BETA-KNH/beta-hardware/beta-main/docs/beta-main.pdf

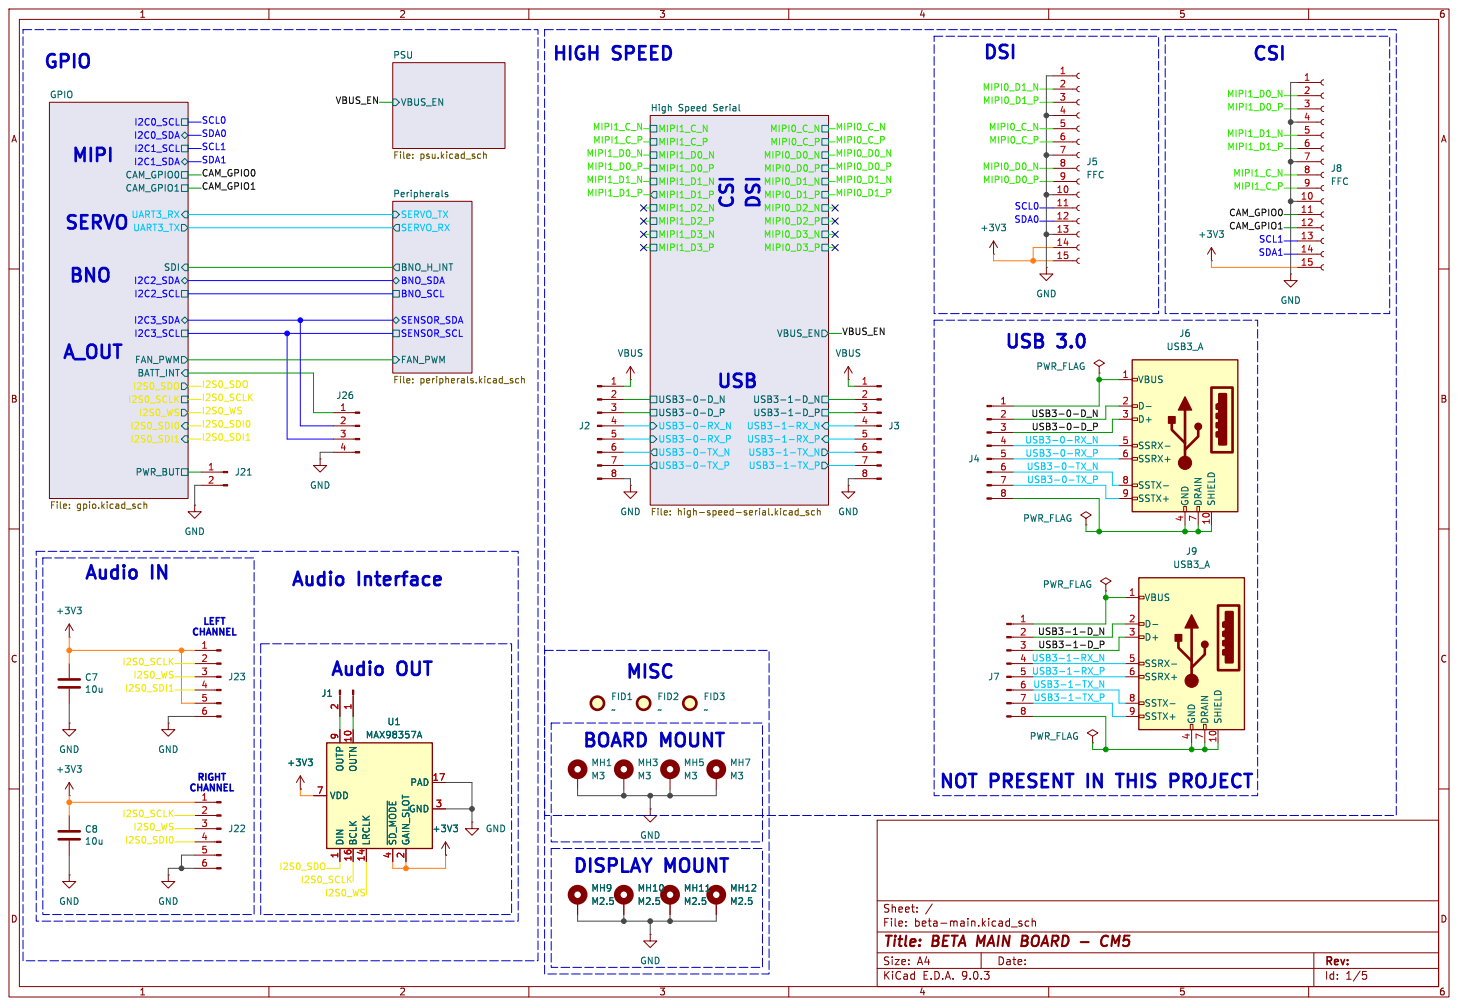
[picture p1: page 1]

DSI
USB3-0-TX_P MIPI1_D3_P MIPI1_D1_P High Speed Serial File: high-speed-serial.kicad_sch

4 VBUS 1 D- 2 D+ 3 SSRX- 5 SSRX+ 6 SSTX- 8 SSTX+ 9

LEFT CHANNEL Audio IN
+3V3 GND

2 GND 3 VDD 7 PAD 17 OUTP

File: beta-main.kicad_sch Sheet: /
Id: 1/5 Title: BETA MAIN BOARD - CM5

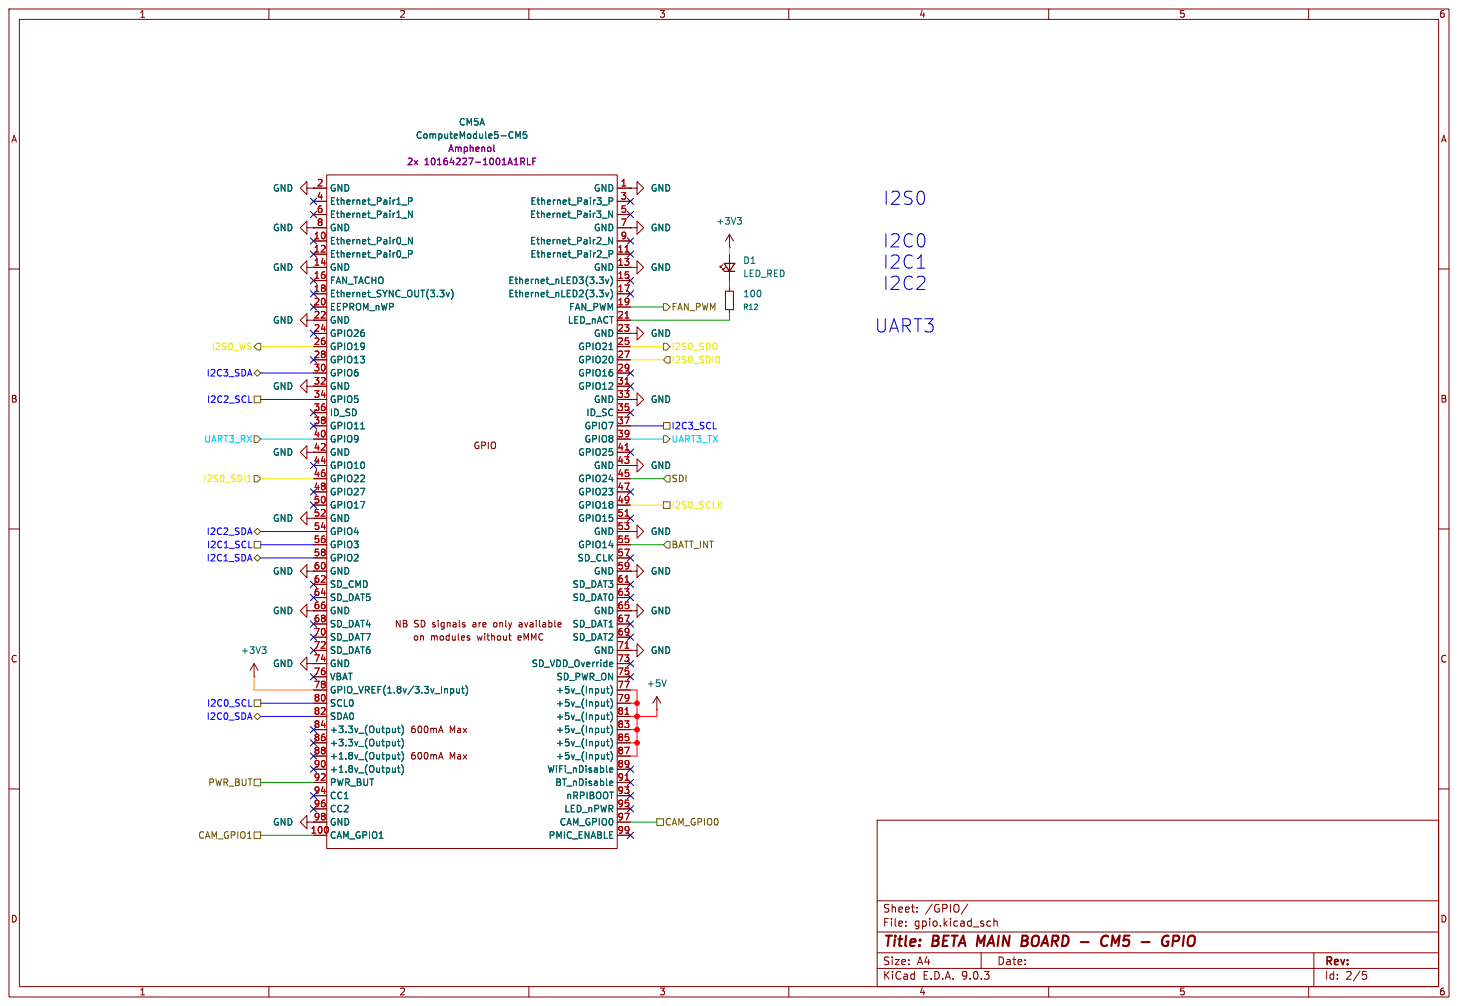
[picture p2: page 2]

GND GND

on modules without eMMC GPIO

600mA Max 600mA Max NB SD signals are only available

File: gpio.kicad_sch Sheet: /GPIO/ GND

Id: 2/5 Title: BETA MAIN BOARD - CM5 - GPIO

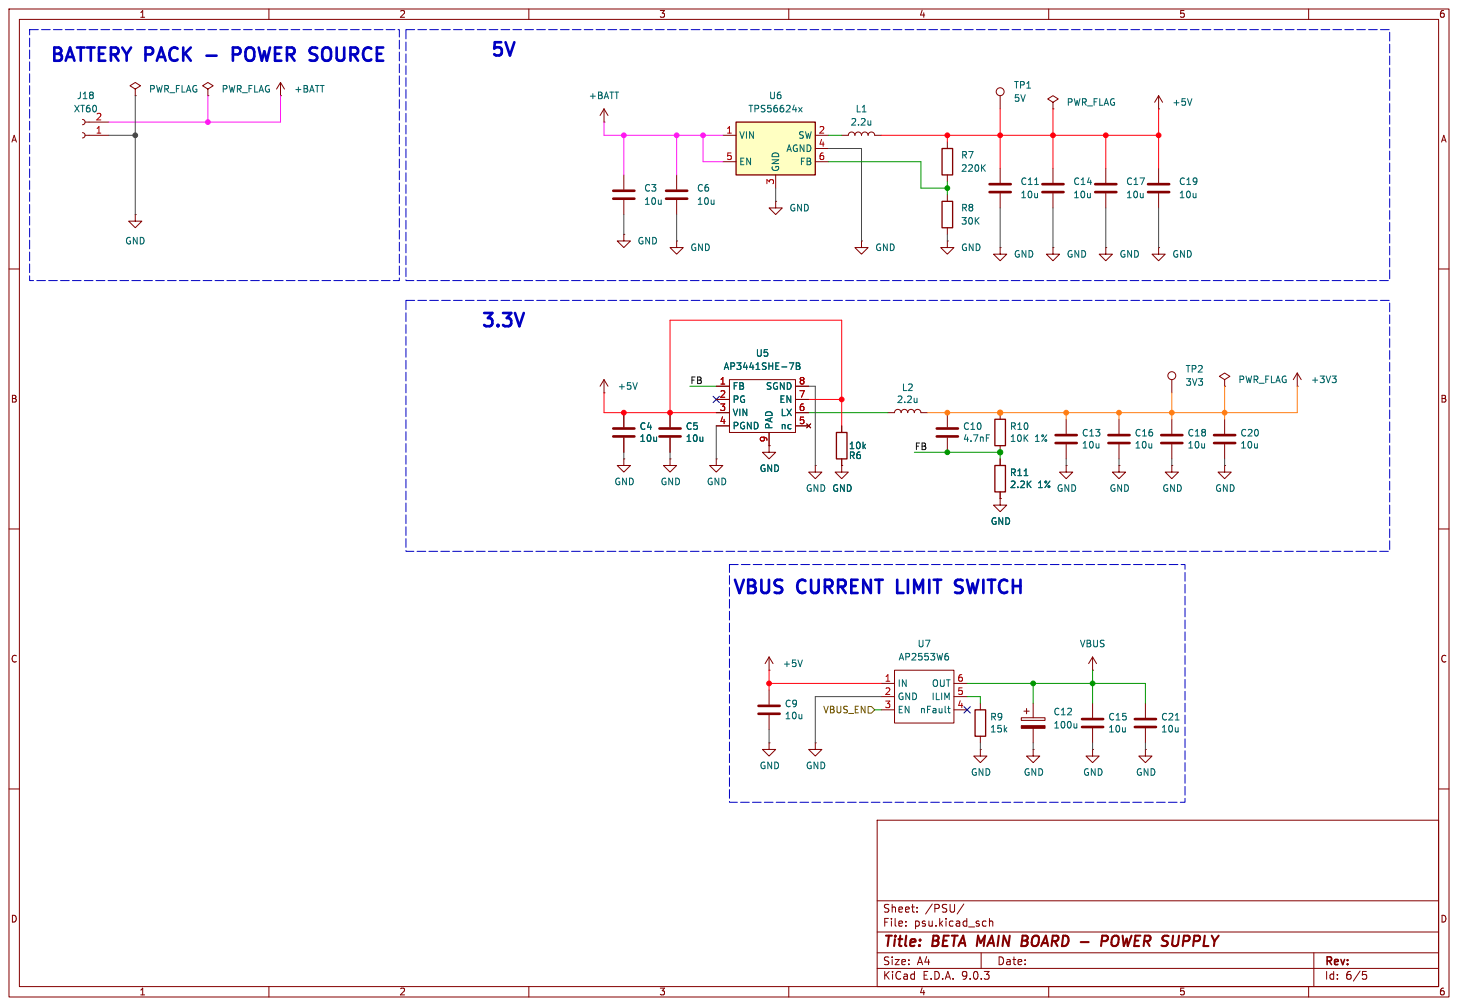
[picture p3: page 3]

3 SW 2 AGND 4 FB 6 U6 TPS56624x GND

File: psu.kicad_sch Sheet: /PSU/
Id: 6/5 Title: BETA MAIN BOARD - POWER SUPPLY

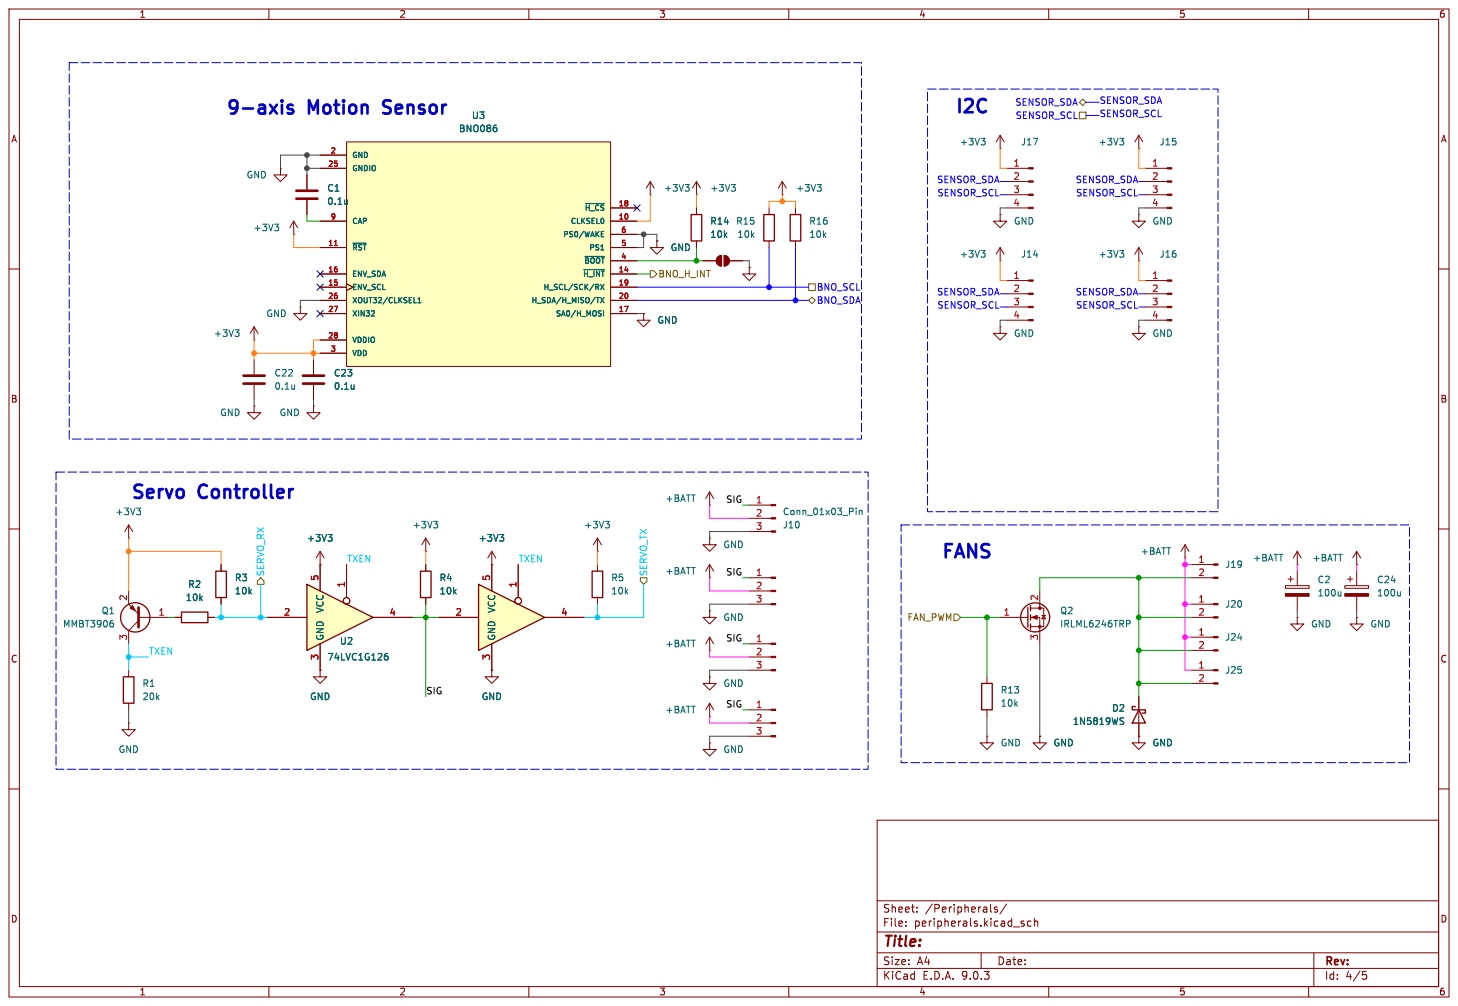
[picture p4: page 4]

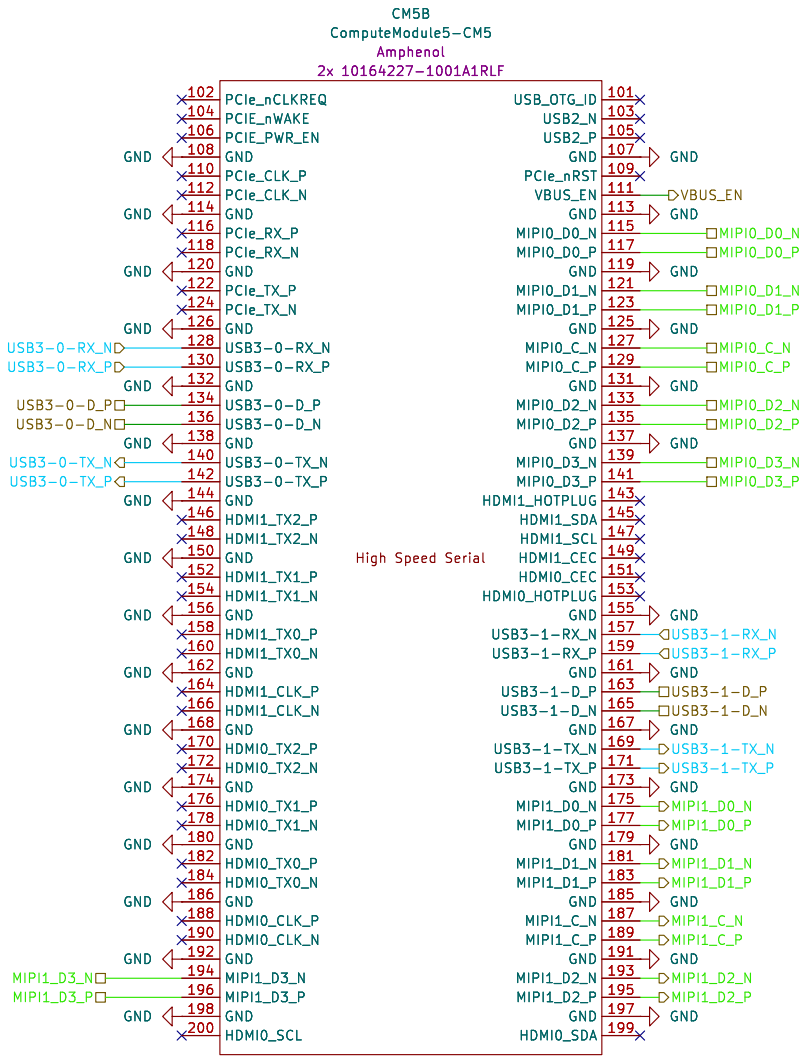
[picture p5: page 5]

GND GND GND GND GND GND GND GND GND

Id: 3/5 Title: BETA MAIN BOARD - CM5 - High Speed Interface
