BETA-KNH/beta-hardware/beta-main/beta-main.kicad_pcb

## KiCad design beta-main/beta-main.kicad_pcb (2026-03-09)

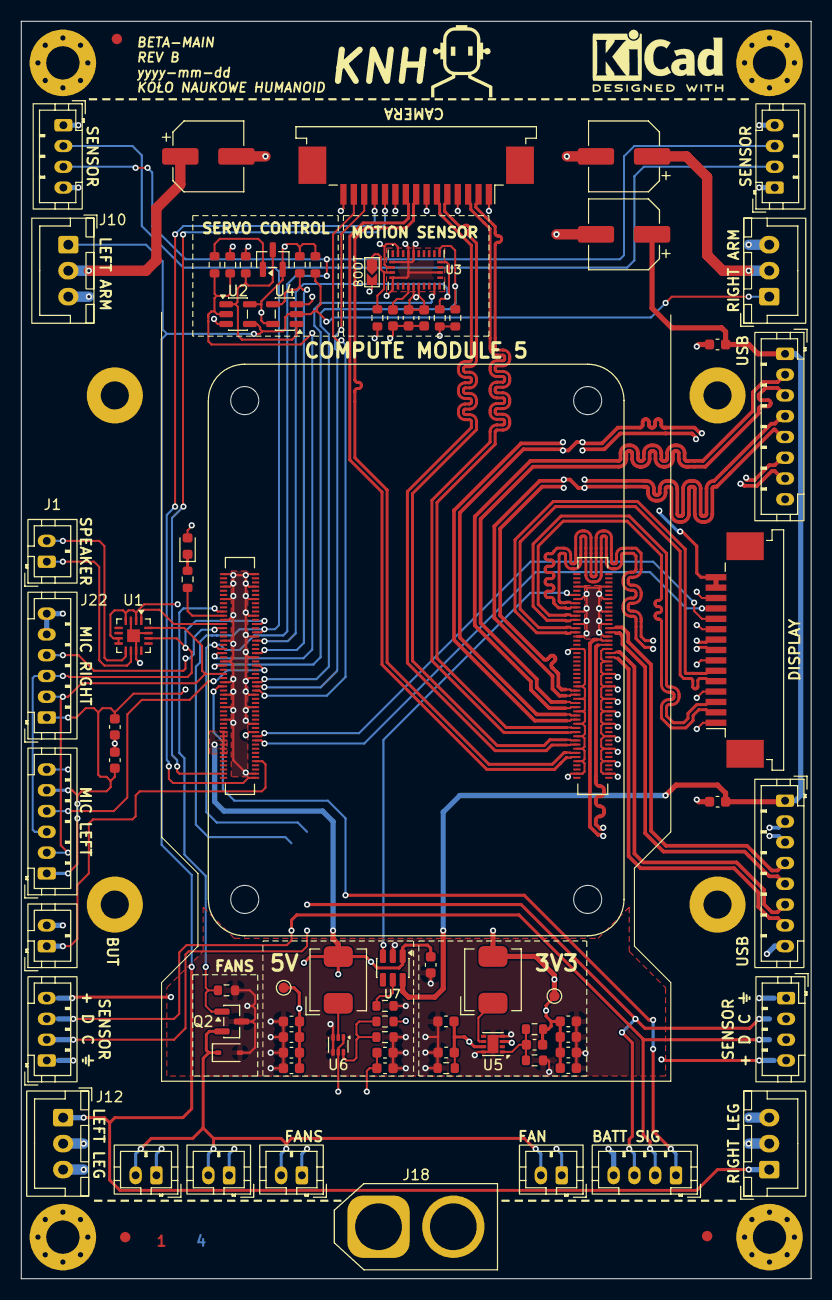
[picture p6: board beta-main.kicad_pcb from above]

Board: 4 copper layers, 76.0 x 121.0 mm, 90 parts (0 on the bottom side), 66 nets.

Parts:
C1, C22, C23: 0.1u; C_0603_1608Metric
C2, C12, C24: 100u; CP_Elec_6.3x5.7
C3, C4, C5, C6, C7, C8, C9, C11, C13, C14, C15, C16, C17, C18, C19, C20, C21: 10u; C_0603_1608Metric
C10: 4.7nF; C_0603_1608Metric
CM5: ComputeModule5-CM5; Raspberry-Pi-5-Compute-Module
D1: LED_RED; LED_0603_1608Metric
D2: 1N5819WS; D_SOD-323
FID1, FID2, FID3: Fiducial_1mm_Mask2mm
J1, J19, J20, J21, J24, J25: Conn_01x02_Pin; JST_PH_B2B-PH-K_1x02_P2.00mm_Vertical
J2, J3: Conn_01x08_Pin; JST_PH_B8B-PH-K_1x08_P2.00mm_Vertical
J5, J8: FFC; TE_1-84953-5_1x15-1MP_P1.0mm_Horizontal
J10, J11, J12, J13: Conn_01x03_Pin; JST_XH_B3B-XH-A_1x03_P2.50mm_Vertical
J14, J15, J16, J17, J26: Conn_01x04_Pin; JST_PH_B4B-PH-K_1x04_P2.00mm_Vertical
J18: XT60; AMASS_XT60-F_1x02_P7.20mm_Vertical
J22, J23: Conn_01x06_Pin; JST_PH_B6B-PH-K_1x06_P2.00mm_Vertical
JP1: SolderJumper_2_Open; SolderJumper-2
L1, L2: 2.2u; L_Bourns_SRP5030CC
MH1, MH3, MH5, MH7: M3; MountingHole_3.2mm_M3_Pad_Via
MH9, MH10, MH11, MH12: M2.5; MountingHole_2.7mm_Pad
Q1: MMBT3906; SOT-23
Q2: IRLML6246TRP; SOT-23
R1: 20k; R_0603_1608Metric
R2, R3, R4, R5, R6, R13, R14, R15, R16: 10k; R_0603_1608Metric
R7: 220K; R_0603_1608Metric
R8: 30K; R_0603_1608Metric
R9: 15k; R_0603_1608Metric
R10: 10K 1%; R_0603_1608Metric
R11: 2.2K 1%; R_0603_1608Metric
R12: 100; R_0603_1608Metric
TP1: 5V; TestPoint_Pad_D1.0mm
TP2: 3V3; TestPoint_Pad_D1.0mm
U1: MAX98357A; TQFN-16-1EP_3x3mm_P0.5mm_EP1.23x1.23mm
U2, U4: 74LVC1G126; SOT-23-5
U3: BNO086; IC_BNO086
U5: AP3441SHE-7B; DFN-8-1EP_2x2mm_P0.5mm_EP1.05x1.75mm
U6: TPS56624x; SOT-563
U7: AP2553W6; SOT-23-6

Connections:
+3V3: C7.1, C8.1, C10.1, C13.1, C16.1, C18.1, C20.1, C22.1, C23.1, CM5.78 (GPIO_VREF(1.8v/3.3v_Input)), D1.2 (A), J5.14, J5.15, J8.15, J14.1, J15.1, J16.1, J17.1, J22.1, J23.1, J23.5, L2.2, Q1.2 (E), R3.1, R4.1, R5.1, R10.1, R14.1, R15.1, R16.1, TP2.1, U1.2 (GAIN_SLOT), U1.4 (~SD_MODE), U1.7 (VDD), U1.8 (VDD), U2.5 (VCC), U3.3 (VDD), U3.10 (CLKSEL0), U3.11 (~RST), U3.28 (VDDIO), U4.5 (VCC)
+5V: C4.1, C5.1, C9.1, C11.1, C14.1, C17.1, C19.1, CM5.77 (+5v_(Input)), CM5.79 (+5v_(Input)), CM5.81 (+5v_(Input)), CM5.83 (+5v_(Input)), CM5.85 (+5v_(Input)), CM5.87 (+5v_(Input)), L1.2, R6.1, R7.1, TP1.1, U5.3 (VIN), U5.7 (EN), U7.1 (IN)
+BATT: C2.1, C3.1, C6.1, C24.1, J10.2, J11.2, J12.2, J13.2, J18.2, J19.1, J20.1, J24.1, J25.1, U6.1 (VIN), U6.5 (EN)
/CAM_GPIO0: CM5.97 (CAM_GPIO0), J8.11
/CAM_GPIO1: CM5.100 (CAM_GPIO1), J8.12
/GPIO/BATT_INT: CM5.55 (GPIO14), J26.1
/GPIO/FAN_PWM: CM5.19 (FAN_PWM), Q2.1 (G), R13.1
/GPIO/I2C2_SCL: CM5.34 (GPIO5), R15.2, U3.19 (H_SCL/SCK/RX)
/GPIO/I2C2_SDA: CM5.54 (GPIO4), R16.2, U3.20 (H_SDA/H_MISO/TX)
/GPIO/PWR_BUT: CM5.92 (PWR_BUT), J21.1
/GPIO/SDI: CM5.45 (GPIO24), U3.14 (~H_INT)
/GPIO/UART3_RX: CM5.40 (GPIO9), R5.2, U4.4
/GPIO/UART3_TX: CM5.39 (GPIO8), R2.2, R3.2, U2.2
/High Speed Serial/USB3-0-D_N: CM5.136 (USB3-0-D_N), J2.2
/High Speed Serial/USB3-0-D_P: CM5.134 (USB3-0-D_P), J2.3
/High Speed Serial/USB3-0-RX_N: CM5.128 (USB3-0-RX_N), J2.4
/High Speed Serial/USB3-0-RX_P: CM5.130 (USB3-0-RX_P), J2.5
/High Speed Serial/USB3-0-TX_N: CM5.140 (USB3-0-TX_N), J2.6
/High Speed Serial/USB3-0-TX_P: CM5.142 (USB3-0-TX_P), J2.7
/High Speed Serial/USB3-1-D_N: CM5.165 (USB3-1-D_N), J3.2
/High Speed Serial/USB3-1-D_P: CM5.163 (USB3-1-D_P), J3.3
/High Speed Serial/USB3-1-RX_N: CM5.157 (USB3-1-RX_N), J3.4
/High Speed Serial/USB3-1-RX_P: CM5.159 (USB3-1-RX_P), J3.5
/High Speed Serial/USB3-1-TX_N: CM5.169 (USB3-1-TX_N), J3.6
/High Speed Serial/USB3-1-TX_P: CM5.171 (USB3-1-TX_P), J3.7
/I2S0_SCLK: CM5.49 (GPIO18), J22.2, J23.2, U1.16 (BCLK)
/I2S0_SDI0: CM5.27 (GPIO20), J22.4
/I2S0_SDI1: CM5.46 (GPIO22), J23.4
/I2S0_SDO: CM5.25 (GPIO21), U1.1 (DIN)
/I2S0_WS: CM5.26 (GPIO19), J22.3, J23.3, U1.14 (LRCLK)
/MIPI0_C_N: CM5.127 (MIPI0_C_N), J5.5
/MIPI0_C_P: CM5.129 (MIPI0_C_P), J5.6
/MIPI0_D0_N: CM5.115 (MIPI0_D0_N), J5.8
/MIPI0_D0_P: CM5.117 (MIPI0_D0_P), J5.9
/MIPI0_D1_N: CM5.121 (MIPI0_D1_N), J5.2
/MIPI0_D1_P: CM5.123 (MIPI0_D1_P), J5.3
/MIPI1_C_N: CM5.187 (MIPI1_C_N), J8.8
/MIPI1_C_P: CM5.189 (MIPI1_C_P), J8.9
/MIPI1_D0_N: CM5.175 (MIPI1_D0_N), J8.2
/MIPI1_D0_P: CM5.177 (MIPI1_D0_P), J8.3
/MIPI1_D1_N: CM5.181 (MIPI1_D1_N), J8.5
/MIPI1_D1_P: CM5.183 (MIPI1_D1_P), J8.6
/PSU/FB: C10.2, R10.2, R11.1, U5.1 (FB)
/Peripherals/SENSOR_SCL: CM5.37 (GPIO7), J14.3, J15.3, J16.3, J17.3, J26.3
/Peripherals/SENSOR_SDA: CM5.30 (GPIO6), J14.2, J15.2, J16.2, J17.2, J26.2
/Peripherals/SIG: J10.1, J11.1, J12.1, J13.1, R4.2, U2.4, U4.2
/Peripherals/TXEN: Q1.3 (C), R1.2, U2.1, U4.1
/SCL0: CM5.80 (SCL0), J5.11
/SCL1: CM5.56 (GPIO3), J8.13
/SDA0: CM5.82 (SDA0), J5.12
/SDA1: CM5.58 (GPIO2), J8.14
/VBUS_EN: CM5.111 (VBUS_EN), U7.3 (EN)
GND: C1.1, C2.2, C3.2, C4.2, C5.2, C6.2, C7.2, C8.2, C9.2, C11.2, C12.2, C13.2, C14.2, C15.2, C16.2, C17.2, C18.2, C19.2, C20.2, C21.2, C22.2, C23.2, C24.2, CM5.1 (GND), CM5.2 (GND), CM5.7 (GND), CM5.8 (GND), CM5.13 (GND), CM5.14 (GND), CM5.22 (GND), CM5.23 (GND), CM5.32 (GND), CM5.33 (GND), CM5.42 (GND), CM5.43 (GND), CM5.52 (GND), CM5.53 (GND), CM5.59 (GND), CM5.60 (GND), CM5.65 (GND), CM5.66 (GND), CM5.71 (GND), CM5.74 (GND), CM5.98 (GND), CM5.107 (GND), CM5.108 (GND), CM5.113 (GND), CM5.114 (GND), CM5.119 (GND), CM5.120 (GND), CM5.125 (GND), CM5.126 (GND), CM5.131 (GND), CM5.132 (GND), CM5.137 (GND), CM5.138 (GND), CM5.144 (GND), CM5.150 (GND), CM5.155 (GND), CM5.156 (GND), CM5.161 (GND), CM5.162 (GND), CM5.167 (GND), CM5.168 (GND), CM5.173 (GND), CM5.174 (GND), CM5.179 (GND), CM5.180 (GND), CM5.185 (GND), CM5.186 (GND), CM5.191 (GND), CM5.192 (GND), CM5.197 (GND), CM5.198 (GND), D2.2 (A), J2.8, J3.8, J5.1, J5.4, J5.7, J5.10, J5.13, J8.1, J8.4, J8.7, J8.10, J10.3, J11.3, J12.3, J13.3, J14.4, J15.4, J16.4, J17.4, J18.1, J21.2, J22.5, J22.6, J23.6, J26.4, JP1.2 (B), MH1.1, MH3.1, MH5.1, MH7.1, MH9.1, MH10.1, MH11.1, MH12.1, Q2.3 (S), R1.1, R6.2, R8.2, R9.2, R11.2, R13.2, U1.3 (GND), U1.11 (GND), U1.15 (GND), U1.17 (PAD), U2.3 (GND), U3.2 (GND), U3.5 (PS1), U3.6 (PS0/WAKE), U3.17 (SA0/H_MOSI), U3.25 (GNDIO), U3.26 (XOUT32/CLKSEL1), U4.3 (GND), U5.4 (PGND), U5.8 (SGND), U5.9 (PAD), U6.3 (GND), U6.4 (AGND), U7.2 (GND)
unnamed: CM5.21 (LED_nACT), R12.1
unnamed: D1.1 (K), R12.2
unnamed: D2.1 (K), J19.2, J20.2, J24.2, J25.2, Q2.2 (D)
unnamed: J1.1, U1.10 (OUTN)
unnamed: J1.2, U1.9 (OUTP)
unnamed: JP1.1 (A), R14.2, U3.4 (~BOOT)
unnamed: Q1.1 (B), R2.1
unnamed: C1.2, U3.9 (CAP)
unnamed: L2.1, U5.6 (LX)
unnamed: R7.2, R8.1, U6.6 (FB)
unnamed: L1.1, U6.2 (SW)
unnamed: R9.1, U7.5 (ILIM)
VBUS: C12.1, C15.1, C21.1, J2.1, J3.1, U7.6 (OUT)
