BETA-KNH/beta-hardware/(commit log)

2026-02-27 add beta-main project
    [beta-main-B_Cu.gbr, beta-main-B_Mask.gbr, beta-main-B_Paste.gbr, beta-main-B_Silkscreen.gbr, beta-main-Edge_Cuts.gbr, beta-main-F_Cu.gbr, beta-main-F_Mask.gbr, beta-main-F_Paste.gbr]
2026-03-09 add schematic's plot
    [beta-main.kicad_pcb]
